Daira-Y/PF/PF_Contro_PCB/Compra/Sample-BOM_JLCSMT (5).xlsx

Comment | Designator | Footprint | JLCPCB Part #（optional）
100nF | C40,C48,C22,C25,C50,C28,C1,C16,C29,C41,C33 | C_0805_2012Metric
ESD321DPYR_C2868952 | D4,D12,D13,D9,D11,D14,D16,D17,D7,D8,D5 | C2868952_X1SON-2_L1_0-W0_6-P0_65-RD-1
10k | R38,R36,R27,R37,R16,R10,R18,R19,R23,R13,R14,R21,R15 | R_0603_1608Metric_Pad0.98x0.95mm_HandSolder
TPM604NY3-2 | U_ACT1,U_ACT3,U_ACT4,U_ACT2 | C7472938_SOT-223-3_L6_5-W3_4-P2_30-LS7_0-BR
100nF | C37,C10,C12,C8,C11,C7,C9,C14,C5,C6,C15,C4,C3 | C_0603_1608Metric
1uF | C38,C44,C49,C47,C51,C46,C39,C45,C36,C43 | C_0603_1608Metric
B340B-13-F | D20,D19,D18,D21 | C85099_SMB_L4_6-W3_6-LS5_3-RD
510 | R4,R5 | R_0603_1608Metric_Pad0.98x0.95mm_HandSolder
TS-1088-AR02016 | boot2,En2 | C720477_SW-SMD_L3_9-W3_0-P4_45
TestPoint | TP-5V1,TP_SCL1,P-12V1,TP_SDA1,TP-3.3V1,TP-PreBuck1,TP-VBUS1 | Pin_D0.7mm_L6.5mm_W1.8mm_FlatFork
MPIT3010-2R2M-LF | L2,L3 | C281241_IND-SMD_L3_0-W3_0_ABG03A
UCC27524ADR | U5,U1 | C185857_SOIC-8_L4_9-W3_9-P1_27-LS6_0-BL
33 | R20,R35,R1,R2,R22,R34 | R_0603_1608Metric_Pad0.98x0.95mm_HandSolder
330 | R40 | R_0603_1608Metric_Pad0.98x0.95mm_HandSolder
SMBJ15A_C83846 | D1 | C83846_SMB_L4_6-W3_6-LS5_3-RD
ESP32-S3-WROOM-1U-N16R8 | U8 | C3013946_WIRELM-SMD_ESP32-S3-WROOM-1U
22uF | C24,C35 | C_0805_2012Metric
ADS1115IDGSR | U2,U3 | C37593_MSOP-10_L3_0-W3_0-P0_50-LS5_0-BL
10uF | C23,C31,C27,C2,C42 | C_0805_2012Metric
DMP4015SPSQ-13 | Q1 | C384564_POWERDI5060-8_L5_8-W4_9-P1_27-LS6_2-BL
B240A | D2,D3 | C39358_SMA_L4_3-W2_6-LS5_2-RD
RZH1E471M1010 | C30,C26 | C47117667_CAP-SMD_BD10_0-L10_3-W10_3-LS11_0-FD
LED_White Yellow | D10 | LED_0603_1608Metric_Pad1.05x0.95mm_HandSolder
4.7k | R39,R6,R7,R11 | R_0603_1608Metric_Pad0.98x0.95mm_HandSolder
RED_LED | D6 | LED_0603_1608Metric_Pad1.05x0.95mm_HandSolder
Conn_01x02_Socket | ACT4,ACT3,ACT2,ACT1 | Molex_KK-254_AE-6410-02A_1x02_P2.54mm_Vertical
MICRO5.9MMUSB | USB1 | C393940_MICRO-USB-SMD_5P-P0_65-H-F_MICRO5_9MMUSB
ESD441DPLR | D15 | C22427765_X2SON-2_L0_6-W0_3-P0_35
TPS62162DSG | U4 | WSON-8-1EP_2x2mm_P0.5mm_EP0.9x1.6mm_ThermalVias
Conn_01x03_Socket | ORP_Sensor3,Temp_Sensor1,Turb_Sensor1,pH_Sensor1,Conduc_Sensor1 | Molex_KK-254_AE-6410-03A_1x03_P2.54mm_Vertical
TPS62163DSGR | U6 | C97534_WSON-8_L2_0-W2_0-P0_50-TL-EP
100k | R12 | R_0805_2012Metric_Pad1.20x1.40mm_HandSolder
Conn_01x06_Pin | Analog_Pin1 | PinSocket_1x06_P2.54mm_Vertical
Conn_01x04_Socket | UART1 | PinSocket_1x04_P2.54mm_Vertical
ZX-XH2.54-4PZZ | Level_Sensor1 | C7429634_CONN-TH_4P-P2_50_4PIN
18k | R17 | R_0603_1608Metric_Pad0.98x0.95mm_HandSolder
Conn_01x02_Socket | 12V_inpu1 | TerminalBlock_Phoenix_MKDS-1,5-2-5.08_1x02_P5.08mm_Horizontal
10uF | C13 | C_0603_1608Metric
Conn_01x14_Socket | GPIO1,Display1 | PinSocket_1x14_P2.54mm_Vertical
