Daira-Y/PF/(list of files, cad)

Other CAD files:
PF_Contro_PCB/PF_Contro_PCB.step
