Daira-Y/PF/PF_Contro_PCB/PF_Contro_PCB.kicad_pcb

## KiCad design PF_Contro_PCB/PF_Contro_PCB.kicad_pcb (2026-11-09)

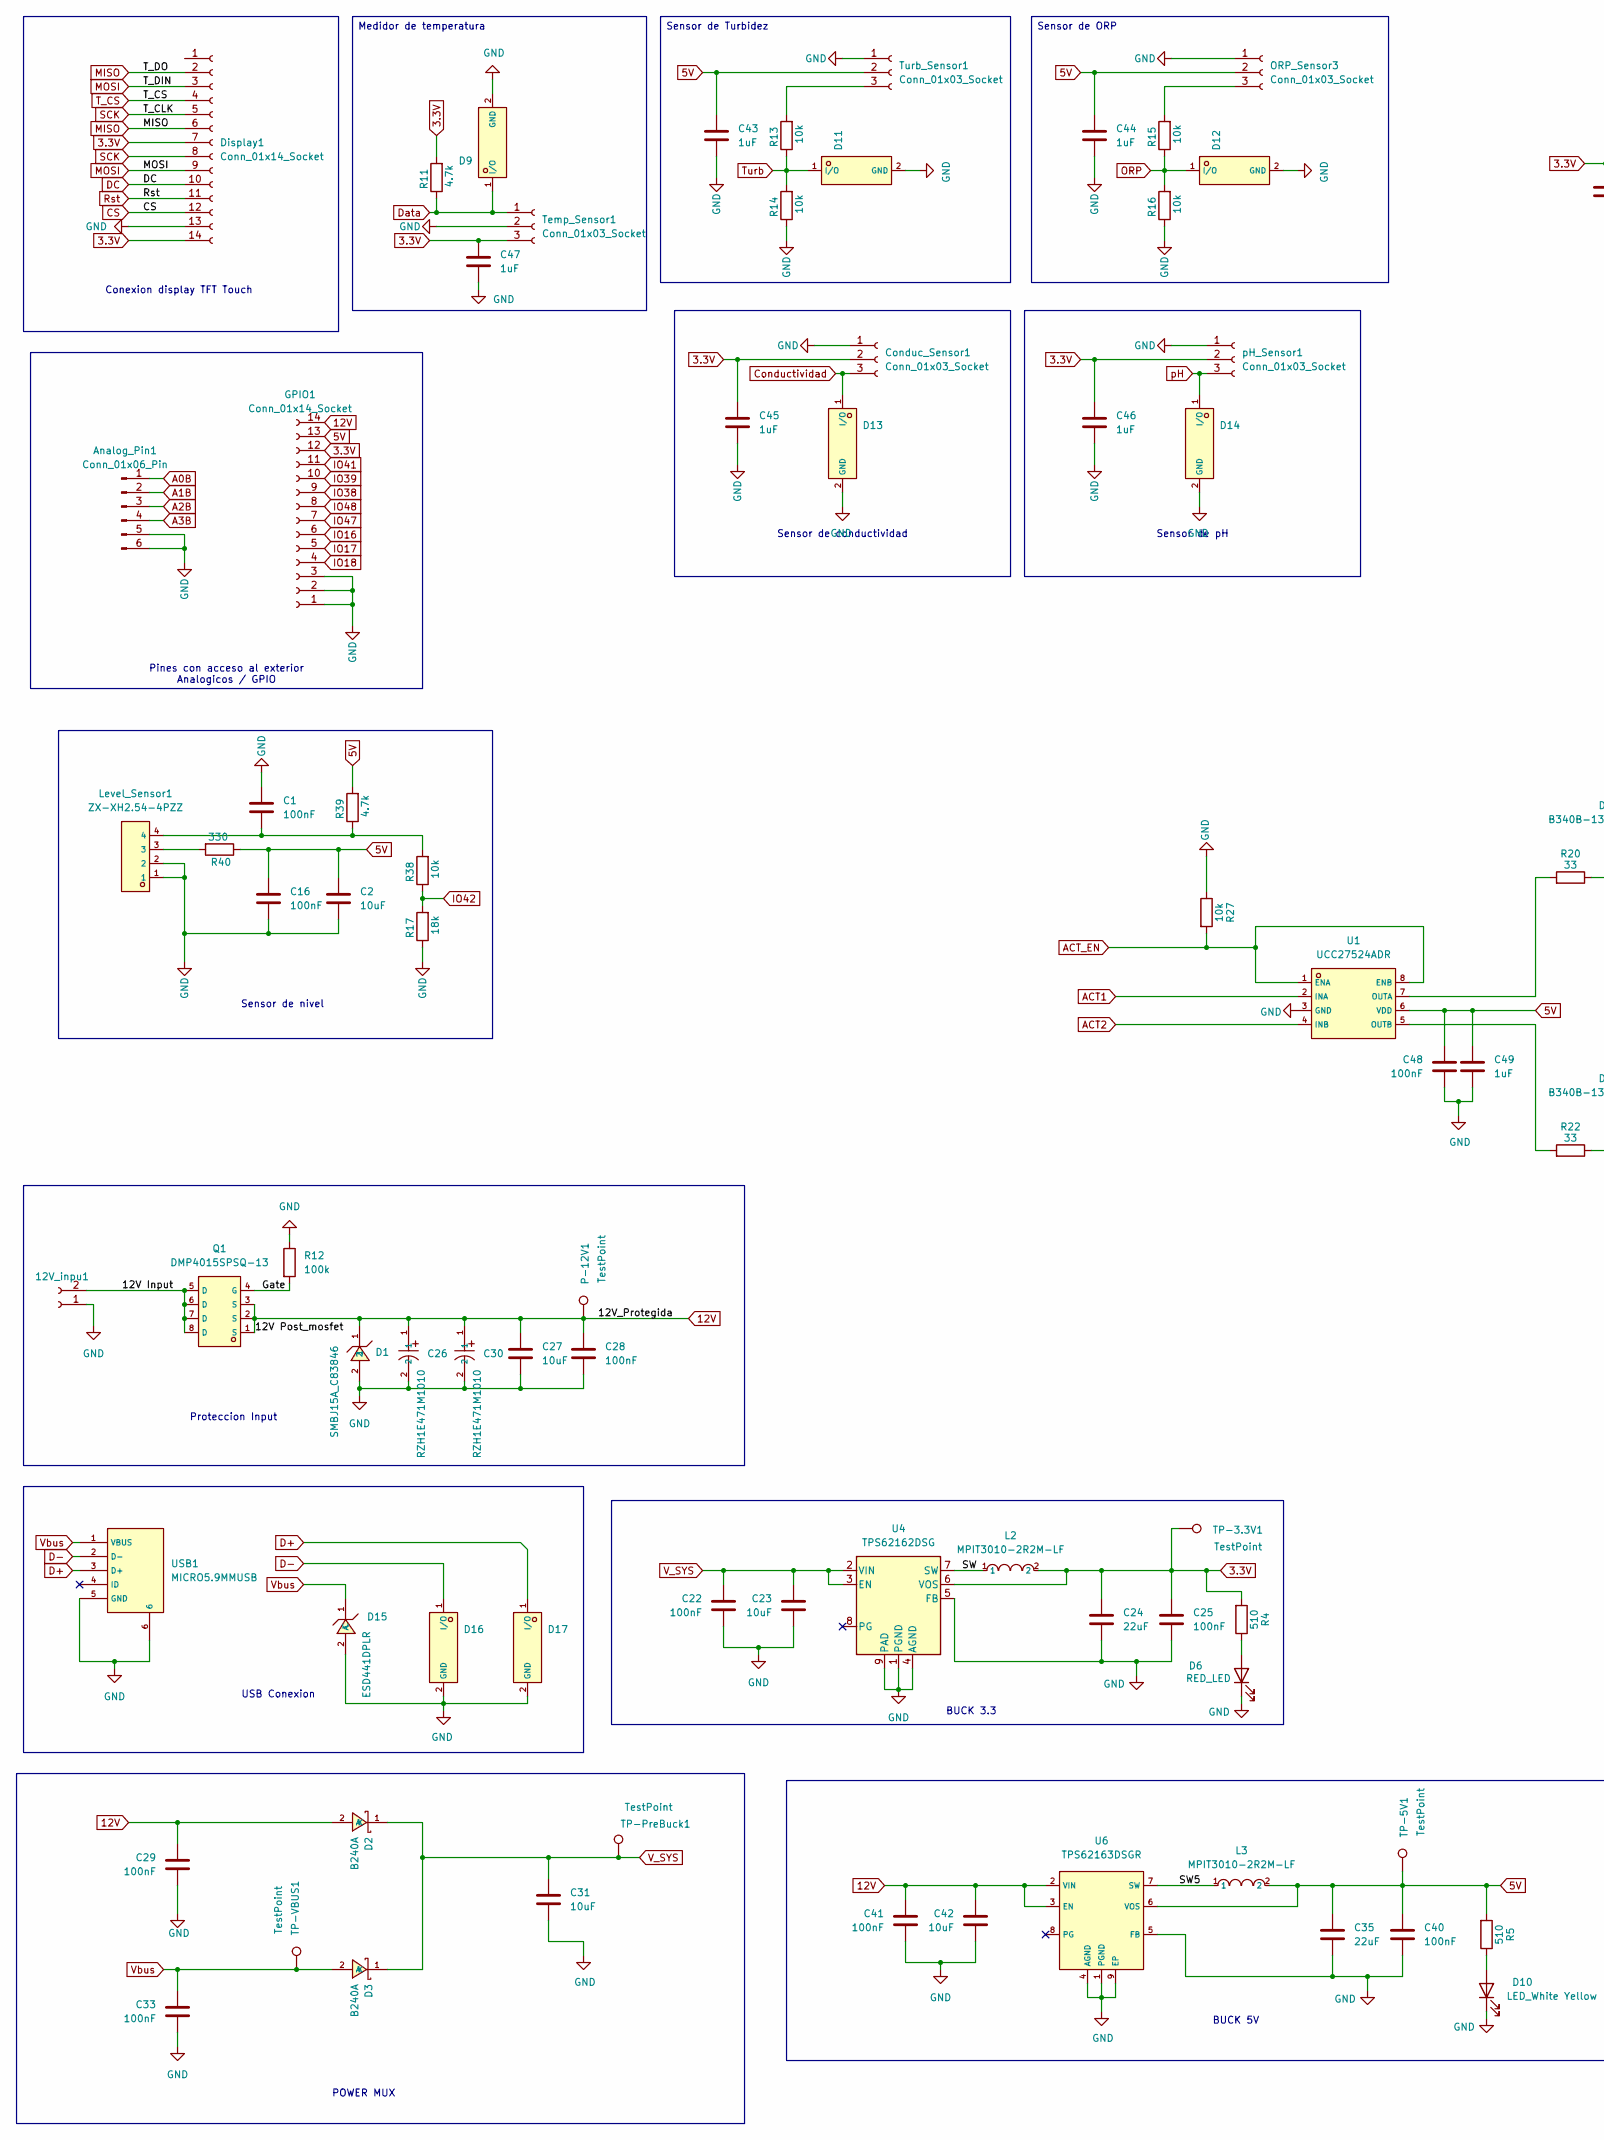
[picture p1: schematic PF_Contro_PCB.kicad_sch, part in row 1, column 1]

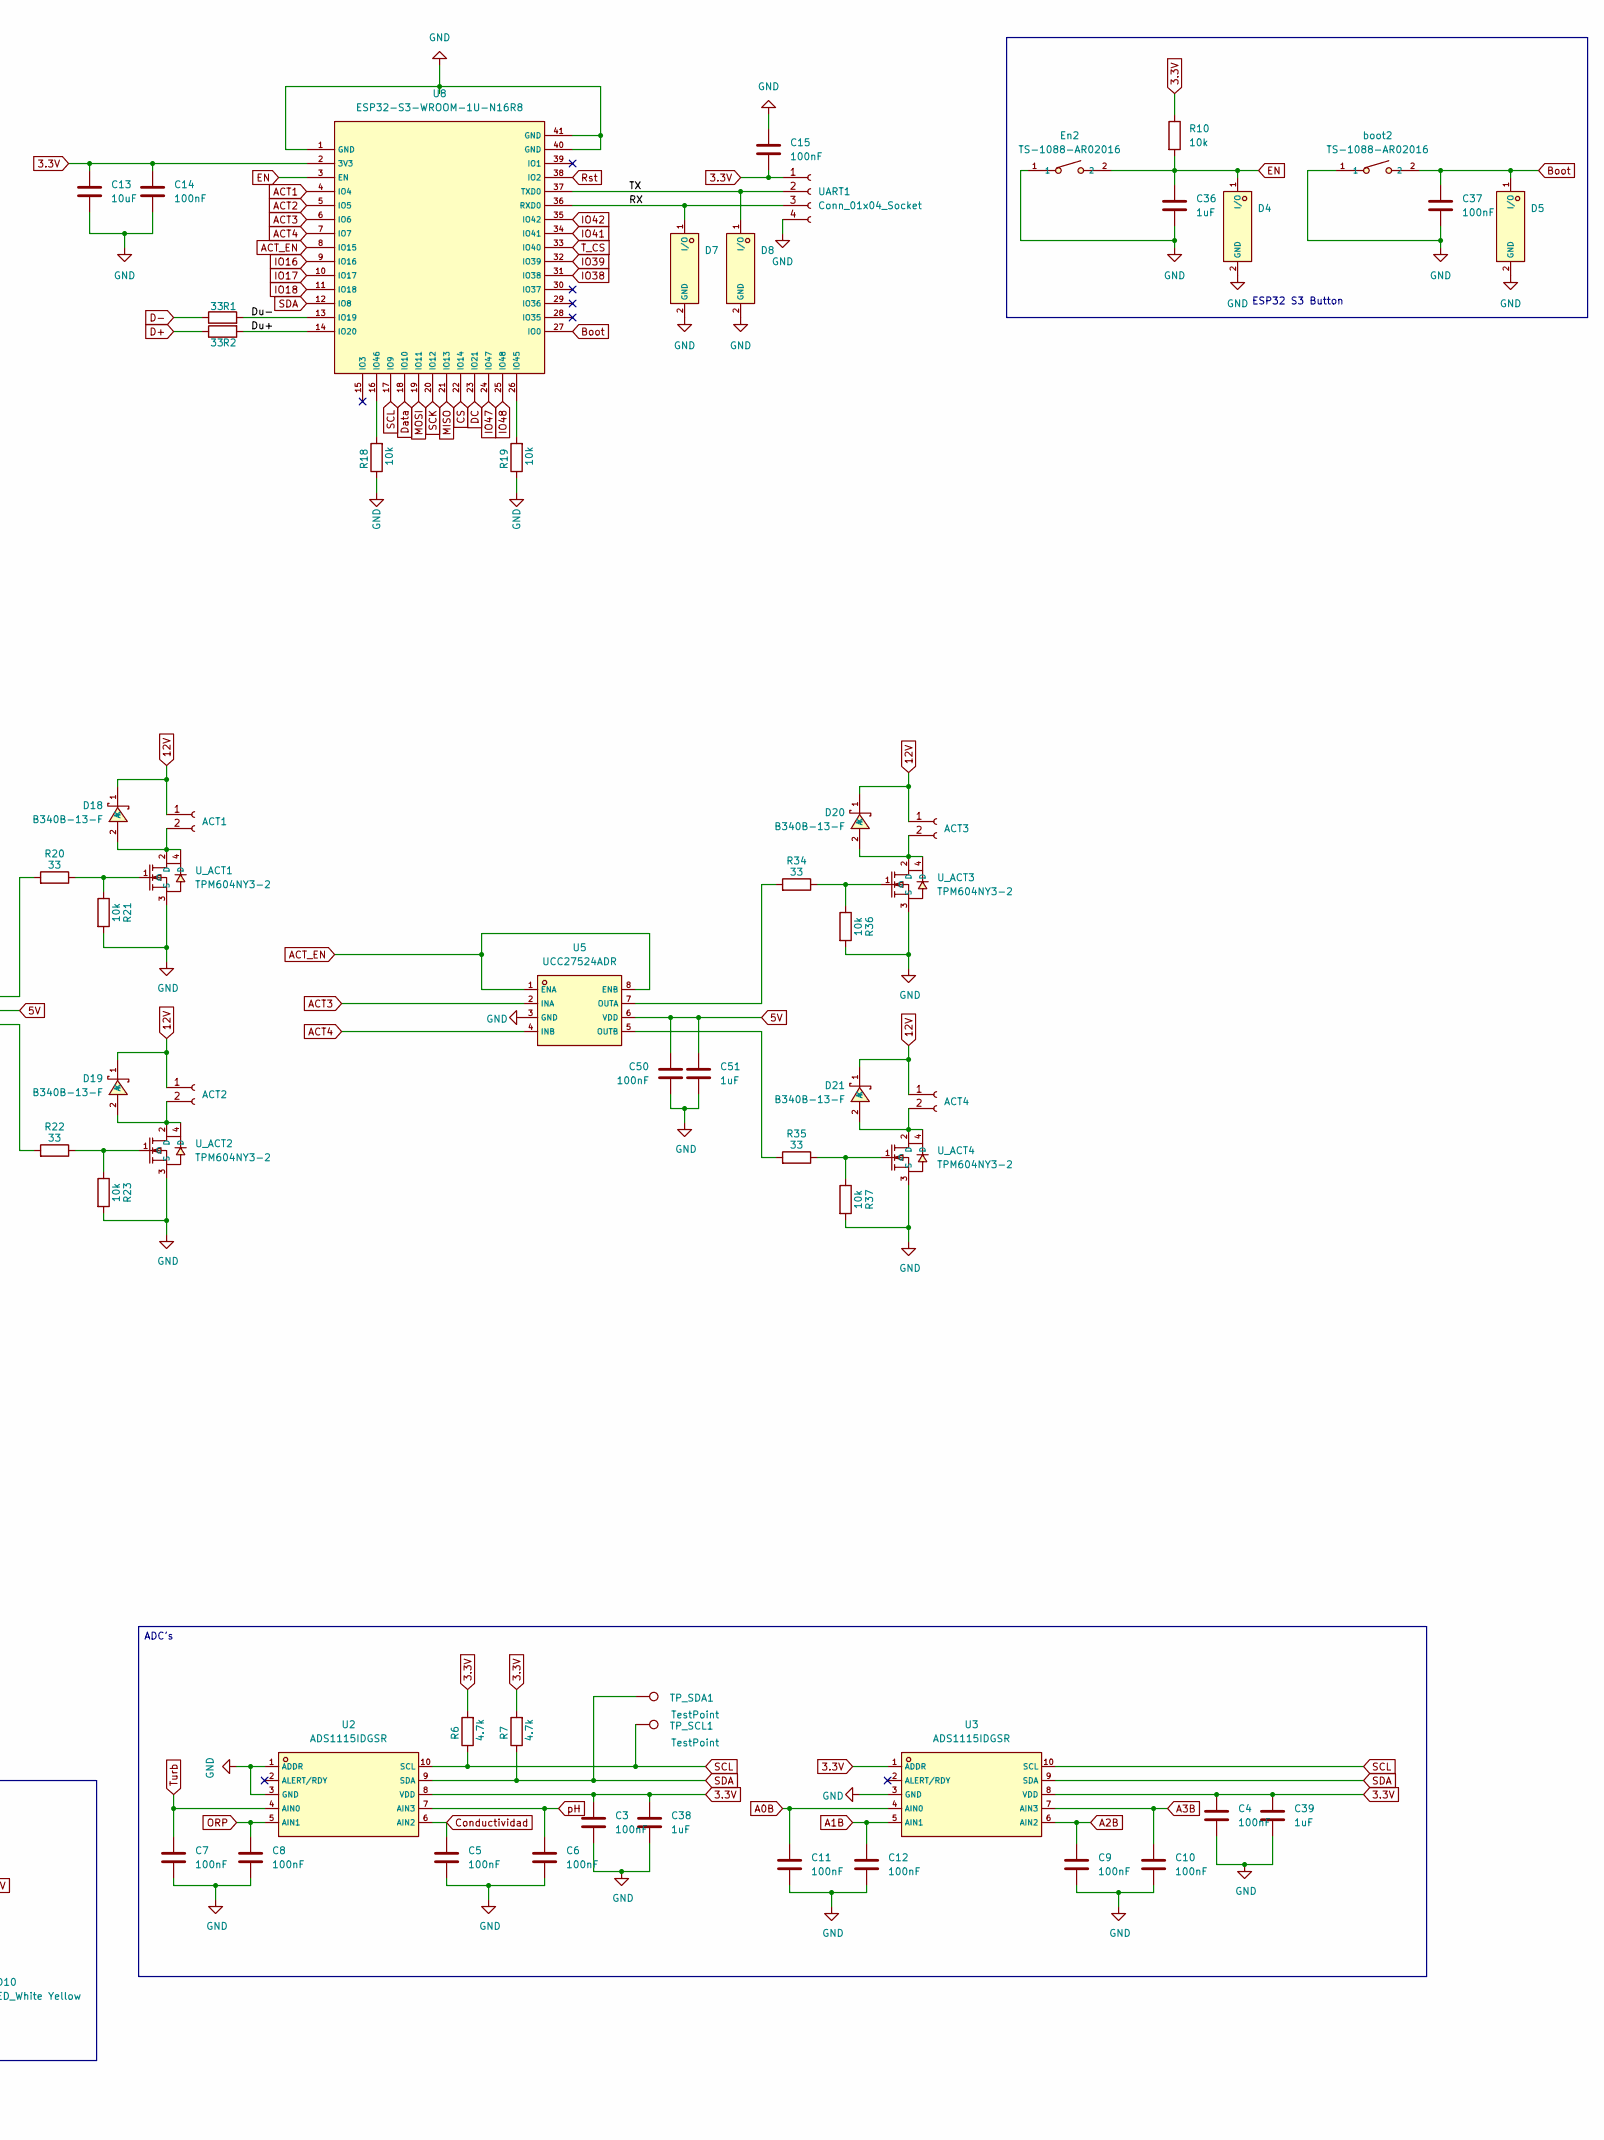
[picture p2: schematic PF_Contro_PCB.kicad_sch, part in row 1, column 2]

Parts:
12V_inpu1: Conn_01x02_Socket; TerminalBlock_Phoenix_MKDS-1,5-2-5.08_1x02_P5.08mm_Horizont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
ACT1, ACT2, ACT3, ACT4: Conn_01x02_Socket; Molex_KK-254_AE-6410-02A_1x02_P2.54mm_Vertical
Analog_Pin1: Conn_01x06_Pin; PinSocket_1x06_P2.54mm_Vertical
C1, C16, C22, C25, C28, C29, C33, C40, C41, C48, C50: 100nF; C_0805_2012Metric
C2, C23, C27, C31, C42: 10uF; C_0805_2012Metric
C3, C4, C5, C6, C7, C8, C9, C10, C11, C12, C14, C15, C37: 100nF; C_0603_1608Metric
C13: 10uF; C_0603_1608Metric
C24, C35: 22uF; C_0805_2012Metric
C26, C30: RZH1E471M1010; C47117667_CAP-SMD_BD10_0-L10_3-W10_3-LS11_0-FD; LCSC C47117667
C36, C38, C39, C43, C44, C45, C46, C47, C49, C51: 1uF; C_0603_1608Metric
Conduc_Sensor1: Conn_01x03_Socket; Molex_KK-254_AE-6410-03A_1x03_P2.54mm_Vertical
D1: SMBJ15A_C83846; C83846_SMB_L4_6-W3_6-LS5_3-RD; LCSC C83846
D2, D3: B240A; C39358_SMA_L4_3-W2_6-LS5_2-RD; LCSC C39358
D4, D5, D7, D8, D9, D11, D12, D13, D14, D16, D17: ESD321DPYR_C2868952; C2868952_X1SON-2_L1_0-W0_6-P0_65-RD-1; LCSC C2868952
D6: RED_LED; LED_0603_1608Metric_Pad1.05x0.95mm_HandSolder
D10: LED_White Yellow; LED_0603_1608Metric_Pad1.05x0.95mm_HandSolder
D15: ESD441DPLR; C22427765_X2SON-2_L0_6-W0_3-P0_35; LCSC C22427765
D18, D19, D20, D21: B340B-13-F; C85099_SMB_L4_6-W3_6-LS5_3-RD; LCSC C85099
Display1: Conn_01x14_Socket; PinSocket_1x14_P2.54mm_Vertical
En2: TS-1088-AR02016; C720477_SW-SMD_L3_9-W3_0-P4_45; LCSC C720477
GPIO1: Conn_01x14_Socket; PinSocket_1x14_P2.54mm_Vertical
L2, L3: MPIT3010-2R2M-LF; C281241_IND-SMD_L3_0-W3_0_ABG03A; LCSC C281241
Level_Sensor1: ZX-XH2.54-4PZZ; C7429634_CONN-TH_4P-P2_50_4PIN; LCSC C7429634
ORP_Sensor3: Conn_01x03_Socket; Molex_KK-254_AE-6410-03A_1x03_P2.54mm_Vertical
P-12V1: TestPoint; Pin_D0.7mm_L6.5mm_W1.8mm_FlatFork
Q1: DMP4015SPSQ-13; C384564_POWERDI5060-8_L5_8-W4_9-P1_27-LS6_2-BL; LCSC C384564
R1, R2, R20, R22, R34, R35: 33; R_0603_1608Metric_Pad0.98x0.95mm_HandSolder
R4, R5: 510; R_0603_1608Metric_Pad0.98x0.95mm_HandSolder
R6, R7, R11, R39: 4.7k; R_0603_1608Metric_Pad0.98x0.95mm_HandSolder
R10, R13, R14, R15, R16, R18, R19, R21, R23, R27, R36, R37, R38: 10k; R_0603_1608Metric_Pad0.98x0.95mm_HandSolder
R12: 100k; R_0805_2012Metric_Pad1.20x1.40mm_HandSolder
R17: 18k; R_0603_1608Metric_Pad0.98x0.95mm_HandSolder
R40: 330; R_0603_1608Metric_Pad0.98x0.95mm_HandSolder
TP-3.3V1, TP-5V1: TestPoint; Pin_D0.7mm_L6.5mm_W1.8mm_FlatFork
TP-PreBuck1: TestPoint; Pin_D0.7mm_L6.5mm_W1.8mm_FlatFork
TP-VBUS1: TestPoint; Pin_D0.7mm_L6.5mm_W1.8mm_FlatFork
TP_SCL1: TestPoint; Pin_D0.7mm_L6.5mm_W1.8mm_FlatFork
TP_SDA1: TestPoint; Pin_D0.7mm_L6.5mm_W1.8mm_FlatFork
Temp_Sensor1: Conn_01x03_Socket; Molex_KK-254_AE-6410-03A_1x03_P2.54mm_Vertical
Turb_Sensor1: Conn_01x03_Socket; Molex_KK-254_AE-6410-03A_1x03_P2.54mm_Vertical
U1, U5: UCC27524ADR; C185857_SOIC-8_L4_9-W3_9-P1_27-LS6_0-BL; LCSC C185857
U2, U3: ADS1115IDGSR; C37593_MSOP-10_L3_0-W3_0-P0_50-LS5_0-BL; LCSC C37593
U4: TPS62162DSG; WSON-8-1EP_2x2mm_P0.5mm_EP0.9x1.6mm_ThermalVias
U6: TPS62163DSGR; C97534_WSON-8_L2_0-W2_0-P0_50-TL-EP; LCSC C97534
U8: ESP32-S3-WROOM-1U-N16R8; C3013946_WIRELM-SMD_ESP32-S3-WROOM-1U; LCSC C3013946
UART1: Conn_01x04_Socket; PinSocket_1x04_P2.54mm_Vertical
USB1: MICRO5.9MMUSB; C393940_MICRO-USB-SMD_5P-P0_65-H-F_MICRO5_9MMUSB; LCSC C393940
U_ACT1, U_ACT2, U_ACT3, U_ACT4: TPM604NY3-2; C7472938_SOT-223-3_L6_5-W3_4-P2_30-LS7_0-BR; LCSC C7472938
boot2: TS-1088-AR02016; C720477_SW-SMD_L3_9-W3_0-P4_45; LCSC C720477
pH_Sensor1: Conn_01x03_Socket; Molex_KK-254_AE-6410-03A_1x03_P2.54mm_Vertical

Connections:
3.3V: C3.1, C4.1, C13.1, C14.1, C15.2, C24.1, C25.1, C38.1, C39.1, C45.1, C46.1, C47.1, Conduc_Sensor1.2, Display1.7, Display1.14, GPIO1.12, L2.2, R4.2, R6.2, R7.2, R10.1, R11.2, TP-3.3V1.1, Temp_Sensor1.3, U2.8 (VDD), U3.1 (ADDR), U3.8 (VDD), U4.6 (VOS), U8.2 (3V3), UART1.1, pH_Sensor1.2
5V: C2.1, C16.1, C35.1, C40.1, C43.1, C44.1, C48.1, C49.1, C50.1, C51.1, GPIO1.13, L3.2, ORP_Sensor3.2, R5.2, R39.2, R40.1, TP-5V1.1, Turb_Sensor1.2, U1.6 (VDD), U5.6 (VDD), U6.6 (VOS)
12V: ACT1.1, ACT2.1, ACT3.1, ACT4.1, C26.1, C27.1, C28.1, C29.1, C30.1, C41.1, C42.1, D1.1, D2.2 (A), D18.1 (K), D19.1 (K), D20.1 (K), D21.1 (K), GPIO1.14, P-12V1.1, Q1.1 (S), Q1.2 (S), Q1.3 (S), U6.2 (VIN), U6.3 (EN)
/12V Input: 12V_inpu1.2, Q1.5 (D), Q1.6 (D), Q1.7 (D), Q1.8 (D)
/Du+: R2.2, U8.14 (IO20)
/Du-: R1.2, U8.13 (IO19)
/Gate: Q1.4 (G), R12.2
/RX: D7.1 (I/O), U8.36 (RXD0), UART1.3
/SW: L2.1, U4.7 (SW)
/SW5: L3.1, U6.7 (SW)
/TX: D8.1 (I/O), U8.37 (TXD0), UART1.2
A0B: Analog_Pin1.1, C11.1, U3.4 (AIN0)
A1B: Analog_Pin1.2, C12.1, U3.5 (AIN1)
A2B: Analog_Pin1.3, C9.1, U3.6 (AIN2)
A3B: Analog_Pin1.4, C10.1, U3.7 (AIN3)
ACT1: U1.2 (INA), U8.4 (IO4)
ACT2: U1.4 (INB), U8.5 (IO5)
ACT3: U5.2 (INA), U8.6 (IO6)
ACT4: U5.4 (INB), U8.7 (IO7)
ACT_EN: R27.2, U1.1 (ENA), U1.8 (ENB), U5.1 (ENA), U5.8 (ENB), U8.8 (IO15)
Boot: C37.1, D5.1 (I/O), U8.27 (IO0), boot2.2
CS: Display1.12, U8.22 (IO14)
Conductividad: C5.1, Conduc_Sensor1.3, D13.1 (I/O), U2.6 (AIN2)
D+: D17.1 (I/O), R2.1, USB1.3 (D+)
D-: D16.1 (I/O), R1.1, USB1.2 (D-)
DC: Display1.10, U8.23 (IO21)
Data: D9.1 (I/O), R11.1, Temp_Sensor1.1, U8.18 (IO10)
EN: C36.1, D4.1 (I/O), En2.2, R10.2, U8.3 (EN)
GND: 12V_inpu1.1, Analog_Pin1.5, Analog_Pin1.6, C1.2, C2.2, C3.2, C4.2, C5.2, C6.2, C7.2, C8.2, C9.2, C10.2, C11.2, C12.2, C13.2, C14.2, C15.1, C16.2, C22.2, C23.2, C24.2, C25.2, C26.2, C27.2, C28.2, C29.2, C30.2, C31.2, C33.2, C35.2, C36.2, C37.2, C38.2, C39.2, C40.2, C41.2, C42.2, C43.2, C44.2, C45.2, C46.2, C47.2, C48.2, C49.2, C50.2, C51.2, Conduc_Sensor1.1, D1.2, D4.2 (GND), D5.2 (GND), D6.1 (K), D7.2 (GND), D8.2 (GND), D9.2 (GND), D10.1 (K), D11.2 (GND), D12.2 (GND), D13.2 (GND), D14.2 (GND), D15.2 (A), D16.2 (GND), D17.2 (GND), Display1.13, En2.1, GPIO1.1, GPIO1.2, GPIO1.3, Level_Sensor1.1, Level_Sensor1.2, ORP_Sensor3.1, R12.1, R14.1, R16.1, R17.1, R18.1, R19.1, R21.2, R23.2, R27.1, R36.2, R37.2, Temp_Sensor1.2, Turb_Sensor1.1, U1.3 (GND), U2.1 (ADDR), U2.3 (GND), U3.3 (GND), U4.1 (PGND), U4.4 (AGND), U4.5 (FB), U4.9 (PAD), U5.3 (GND), U6.1 (PGND), U6.4 (AGND), U6.5 (FB), U6.9 (EP), U8.1 (GND), U8.40 (GND), U8.41 (GND), UART1.4, USB1.5 (GND), USB1.6, U_ACT1.3 (S), U_ACT2.3 (S), U_ACT3.3 (S), U_ACT4.3 (S), boot2.1, pH_Sensor1.1
IO16: GPIO1.6, U8.9 (IO16)
IO17: GPIO1.5, U8.10 (IO17)
IO18: GPIO1.4, U8.11 (IO18)
IO38: GPIO1.9, U8.31 (IO38)
IO39: GPIO1.10, U8.32 (IO39)
IO41: GPIO1.11, U8.34 (IO41)
IO42: R17.2, R38.1, U8.35 (IO42)
IO47: GPIO1.7, U8.24 (IO47)
IO48: GPIO1.8, U8.25 (IO48)
MISO: Display1.2, Display1.6, U8.21 (IO13)
MOSI: Display1.3, Display1.9, U8.19 (IO11)
unnamed: ACT1.2, D18.2 (A), U_ACT1.2 (D), U_ACT1.4 (D)
unnamed: ACT2.2, D19.2 (A), U_ACT2.2 (D), U_ACT2.4 (D)
unnamed: ACT3.2, D20.2 (A), U_ACT3.2 (D), U_ACT3.4 (D)
unnamed: ACT4.2, D21.2 (A), U_ACT4.2 (D), U_ACT4.4 (D)
unnamed: C1.1, Level_Sensor1.4, R38.2, R39.1
unnamed: D6.2 (A), R4.1
unnamed: D10.2 (A), R5.1
unnamed: Level_Sensor1.3, R40.2
unnamed: ORP_Sensor3.3, R15.2
unnamed: R13.2, Turb_Sensor1.3
unnamed: R20.2, U1.7 (OUTA)
unnamed: R22.2, U1.5 (OUTB)
unnamed: R34.2, U5.7 (OUTA)
unnamed: R35.2, U5.5 (OUTB)
unnamed: R19.2, U8.26 (IO45)
unnamed: R18.2, U8.16 (IO46)
unnamed: R20.1, R21.1, U_ACT1.1 (G)
unnamed: R22.1, R23.1, U_ACT2.1 (G)
unnamed: R34.1, R36.1, U_ACT3.1 (G)
unnamed: R35.1, R37.1, U_ACT4.1 (G)
ORP: C8.1, D12.1 (I/O), R15.1, R16.2, U2.5 (AIN1)
Rst: Display1.11, U8.38 (IO2)
SCK: Display1.5, Display1.8, U8.20 (IO12)
SCL: R6.1, TP_SCL1.1, U2.10 (SCL), U3.10 (SCL), U8.17 (IO9)
SDA: R7.1, TP_SDA1.1, U2.9 (SDA), U3.9 (SDA), U8.12 (IO8)
T_CS: Display1.4, U8.33 (IO40)
Turb: C7.1, D11.1 (I/O), R13.1, R14.2, U2.4 (AIN0)
V_SYS: C22.1, C23.1, C31.1, D2.1 (K), D3.1 (K), TP-PreBuck1.1, U4.2 (VIN), U4.3 (EN)
Vbus: C33.1, D3.2 (A), D15.1 (C), TP-VBUS1.1, USB1.1 (VBUS)
pH: C6.1, D14.1 (I/O), U2.7 (AIN3), pH_Sensor1.3

Notes on the sheet:
BUCK 5V
POWER MUX
ESP32 S3 Button
Conexion display TFT Touch
BUCK 3.3
Sensor de nivel
USB Conexion
Proteccion Input
Medidor de temperatura
Sensor de conductividad
Sensor de ORP
Pines con acceso al exterior Analogicos / GPIO
Sensor de Turbidez
ADC's
Sensor de pH

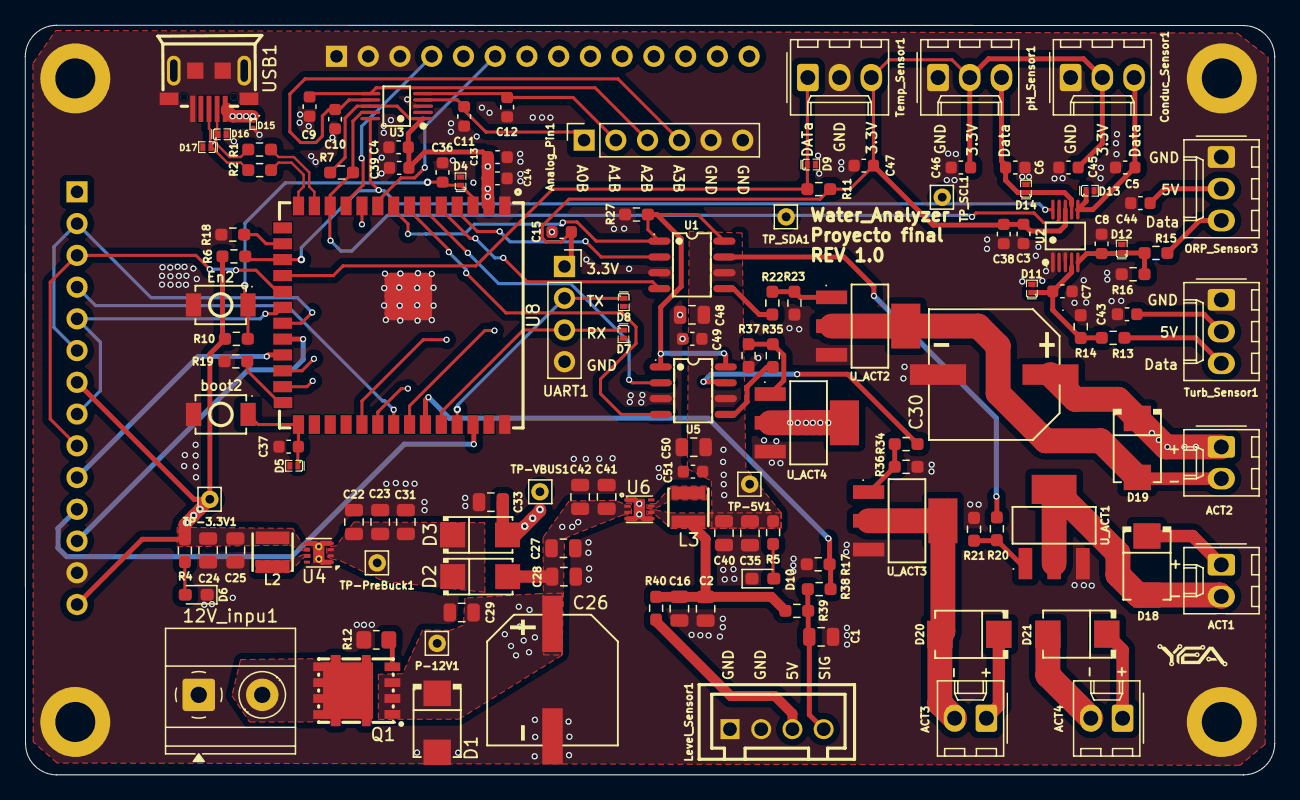
[picture p3: board PF_Contro_PCB.kicad_pcb from above]

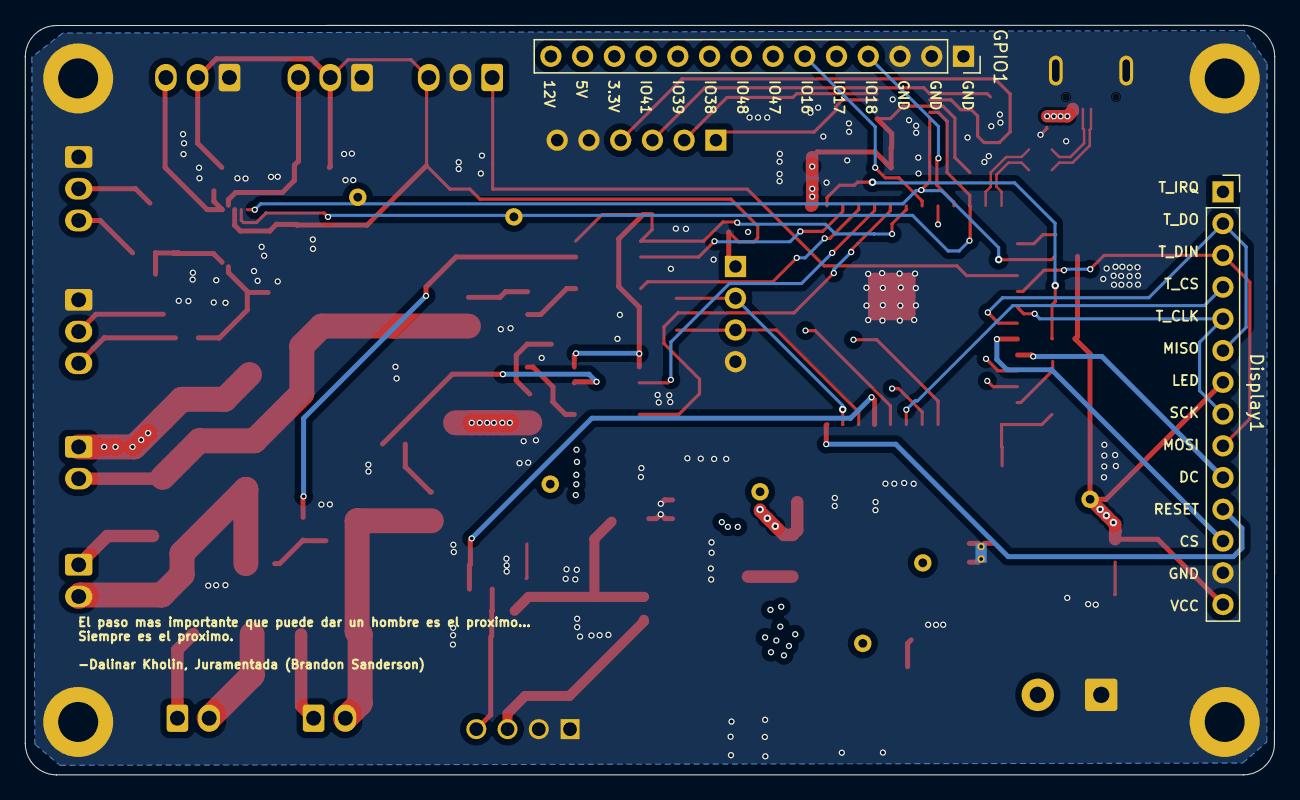
[picture p4: board PF_Contro_PCB.kicad_pcb from below]

Board: 4 copper layers, 100.0 x 60.0 mm, 132 parts (2 on the bottom side), 70 nets.
