Daira-Y/PF/(commit log)

2026-10-29 Add KiCad PCB project
2026-10-30 Cambio de conectores / Comienzo Component Placement
2026-11-04 Reglas de diseño definidas / Esquematico Check
2026-11-04 Inicio de Enrute
2026-11-09 Correciones menores / Generacion de archivos de compra
